ArminJo/Arduino-DTSU666H_PowerMeter/(commit log)

2023-12-21 Added reply to 0x2014 (Power in 0.1 W units) and 0x0006 (Current transformer rate IrAt)
2024-02-09 Error handling and watchdog added to improve stability
    [Arduino-DTSU666H_PowerMeter.ino]
2024-02-09 Fix LCD power-sum bug
    [Arduino-DTSU666H_PowerMeter.ino]
2024-03-03 Added direct_pin input to show non lowpass filtered data
2024-05-29 Button handling
2025-05-01 Fixed Overflow bug on Wh page, 3. Party libs
    [AVRUtils.h, Arduino-DTSU666H_PowerMeter.ino]
2026-01-21 removed button autorepeat
2026-04-04 Added PowerMeter
